aitormrtn/KEYHOME_PROYECT/README.md

# KEYHOME_PROYECT
Proyecto dedicado a la automatización de la reserva de viviendas de alquiler con caracter vacacional
