aitormrtn/KEYHOME_PROYECT/Memoria/tex/simbolos.tex

\chapter*{Lista de símbolos}\label{LDS}

\avisoLocalizacionArchivo

\begin{longtable}{lcp{.8\textwidth} }
\multicolumn{3}{l}{\textbf{Mayúsculas}}\\
\\
$V$ & --- & Voltaje (V).\\
\end{longtable}
