aitormrtn/KEYHOME_PROYECT/Memoria/README.md

# Plantilla para TFG en EII - UCLM

Este repositorio es una plantilla de trabajo fin de grado.

Los alumnos a los que dirijo el TFG tendrán que usarla a partir del curso 2018-2019.

## Usar la plantilla

1. Hazte una cuenta de GitHub y haz un fork de este repositorio.
1. Añade a mi usuario FranciscoMoya como uno de los colaboradores de tu nuevo repositorio.
1. Descarga como un zip el repositorio.
1. Hazte una cuenta en [Overleaf](https://v2.overleaf.com/).
1. Crea un nuevo proyecto a partir del ZIP descargado de GitHub.  Para ello pincha en *Nuevo proyecto* y selecciona *Subir proyecto*. 
1. Cada vez que tengas cambios significativos descarga los fuentes de Overleaf y súbelos a GitHub.  Para ello tendrás que aprender a usar un repositorio GitHub desde tu ordenador personal.
