aitormrtn/KEYHOME_PROYECT/Memoria/TFG.tex

\documentclass{sty/eiiatfg}

% Hay muchos paquetes para LaTeX que facilitan centenares de trabajos
% engorrosos. Busca en Internet si no sabes hacer algo con LaTeX. El
% repositorio oficial está en https://ctan.org/

% Algunos paquetes especialmente útiles ya están incluídos en el estilo
% del TFG (consulta sty/eiiatfg.cls para más detalles).

\input{datos-tfg.tex}
\input{acronimos.tex}

% La bibliografía la puedes descomponer en varios archivos .bib
% Los archivos .bib se pueden escribir a mano con ayuda de un editor online
% (e.g. http://truben.no/latex/bibtex) o generar con Mendeley u otro
% gestor de bibliografía. Solo se incluyen las referencias que son citadas
% en el texto.
\addbibresource{bib/main.bib}
%\addbibresource{bib/how.bib}
%\addbibresource{bib/ejemplos.bib}

\fxsetup{draft,lang=spanish,theme=color,inlineface=\bfseries,marginface=\bfseries,layout={marginclue,inline,index}}

\begin{document}

% Puedes cambiar la licencia de este documento con la orden license.  Por defecto se asume Creative Commons Attribution 4.0 (ver https://creativecommons.org/licenses/by/4.0/).  
% Por ejemplo, para restringir su uso, copia y distribución:
%\license{Todos los derechos reservados.}

% Si usas muchos símbolos conviene que describas lo que significan en un archivo
% aparte (en este caso simbolos.tex).  Si no es el caso puedes comentar esta línea
\listofsymbols{simbolos.tex}

\portada
\input{agradecimientos.tex}	   
\input{dedicatoria.tex}
\input{resumen.tex}

\indices
%Poniendo \if0 hacemos que los puntos que haya debajo no se compilen
%\fi %% fin de \if0 A partir de aquí el \if0 ya no tendría efecto
% Para incluir un fragmento basta sustituir el \if0 por \if00 (un cero más).

% El cuerpo del documento está en la carpeta tex
% Aquí simplemente se incluyen los archivos correspondientes a cada capítulo.

% No los llames capitulo1, capitulo2, etc. Los números los pondrá LaTeX según
% el orden en que los pongas.  Eso facilitará después su posible reordenación
% o división.

% Esta estructura corresponde a un documento científico-técnico.
% Si ves que tu proyecto concuerda con un trabajo profesional organiza el 
% documento según UNE 157001

\if00
\input{introduccion.tex}
\fi

\if00
\input{objetivos.tex}
\fi

\if00
\input{antecedentes.tex}
\fi

\if00
\input{procedimiento.tex}
\fi

\if00
\input{desarrollo.tex}
\fi

\if00
\input{resultados.tex}
\fi

\if00
\input{tex/discusion-resultados}
\fi

\if00
\input{conclusiones.tex}
\fi

% Los anexos pueden ir en la misma carpeta que el cuerpo del documento 
% porque eso facilita la migración de partes de un capítulo a un anexo.
\appendix\cleardoublepage
\if0
\hypertarget{ch:anexos}{%
    \input{latex.tex}}
\fi
% La bibliografía no suele ir numerada porque se pone después de los anexos.
% No se debe poner antes de los anexos porque si se cita una referencia en
% un anexo sería una backward reference, que deben evitarse a toda costa
\cleardoublepage
\hypertarget{ch:bibliografia}{%
    \printbibliography[heading=bibintoc,title={Bibliografía}]}
\cleardoublepage

\end{document}
