aitormrtn/KEYHOME_PROYECT/Memoria/tex/agradecimientos.tex

\begin{agradecimientos}
\noindent Quiero agradecerle a mi familia, especialmente a mis padres y a mi tío Javier, por haberme brindado la oportunidad de obtener una formación de calidad, ayudándome en todo momento de forma incondicional.

También quiero darle las gracias al tutor de este trabajo, Francisco Moya, por acercar el mundo de la programación a mi vida, y en general, a todos los docentes que me han acompañado en el camino, con especial atención por aquellos que sienten pasión por su trabajo y se la transmiten a sus alumnos.
\end{agradecimientos}
