aitormrtn/KEYHOME_PROYECT/Memoria/tex/dedicatoria.tex

\begin{dedicatoria}
Esta obra está dedicada a la memoria de Alan Turing, cuya contribución tecnológica hace posible, entre otras muchas cosas, este trabajo de fin de grado.
\end{dedicatoria}
