aitormrtn/KEYHOME_PROYECT/Memoria/fig/Conexion-Portero-Cerradura.PNG

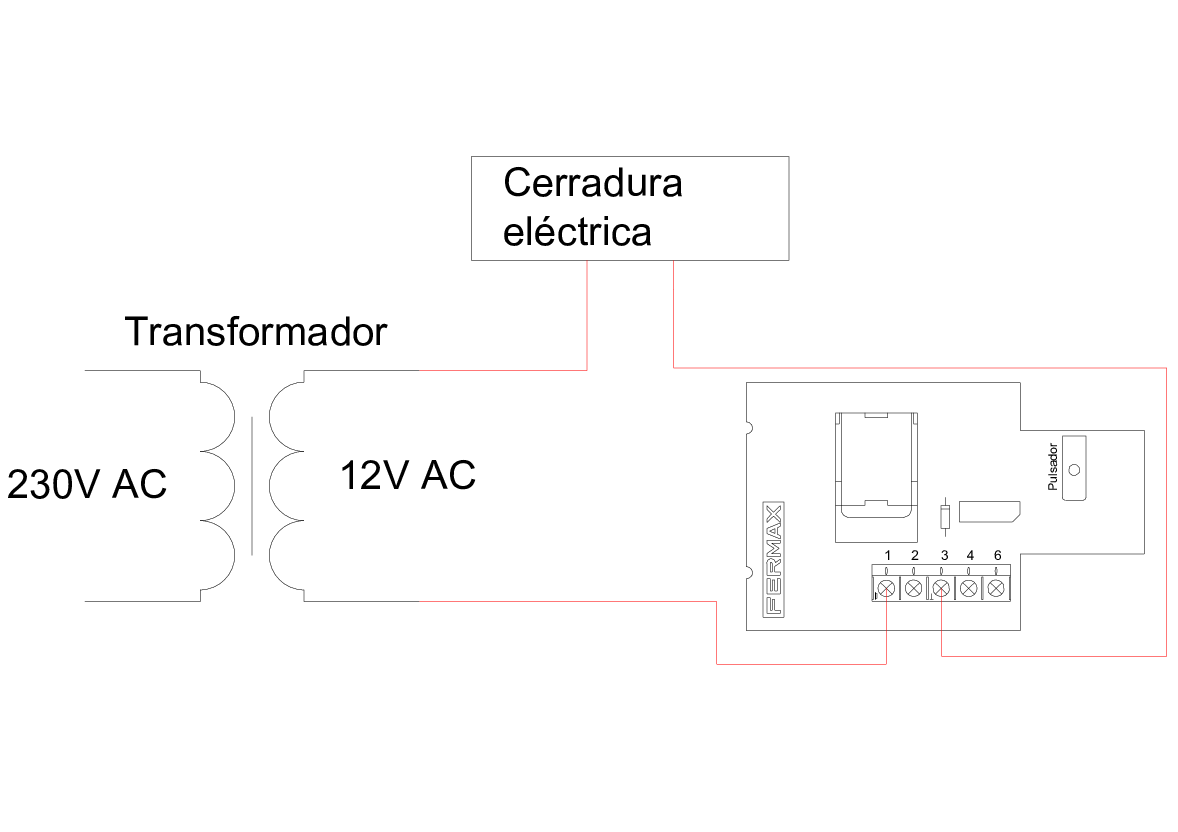
Memoria/fig/Conexion-Portero-Cerradura.PNG
