aitormrtn/KEYHOME_PROYECT/Memoria/fig/Proceso_Nueva_Reserva.png

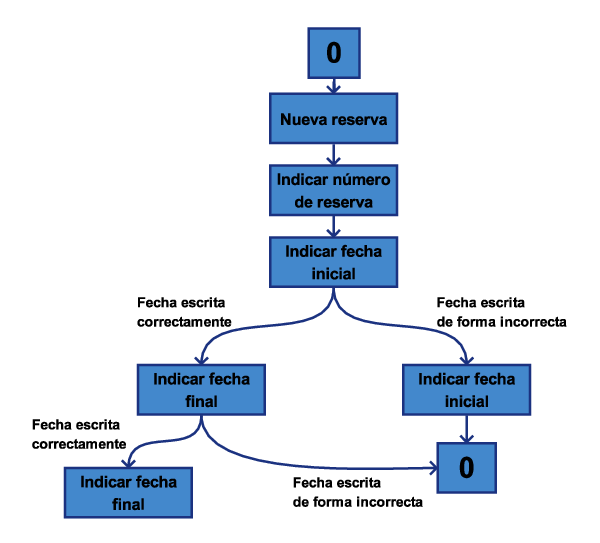
Memoria/fig/Proceso_Nueva_Reserva.png
