aitormrtn/KEYHOME_PROYECT/3D/Keyhome v5.step

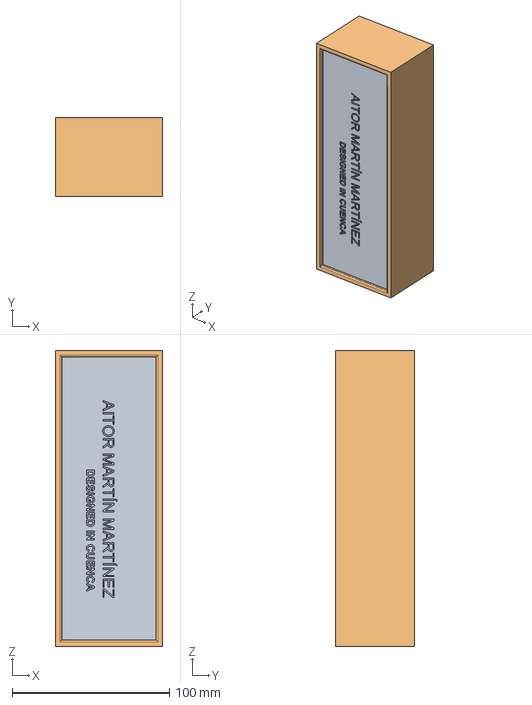
[picture p23: CAD file, 2020-03-31]
3D/Keyhome v5.step
68.0 x 50.0 x 188.0 mm
BASE V1
TAPA V1
