aitormrtn/KEYHOME_PROYECT/(list of files, cad)

Other CAD files:
3D/Keyhome v5.dwg
3D/Keyhome v5.f3d
3D/Keyhome v5.obj
3D/Keyhome v5.skp
3D/Keyhome v5.stl
