aitormrtn/KEYHOME_PROYECT/Memoria/fig/conexion-keyhome-completa.pdf

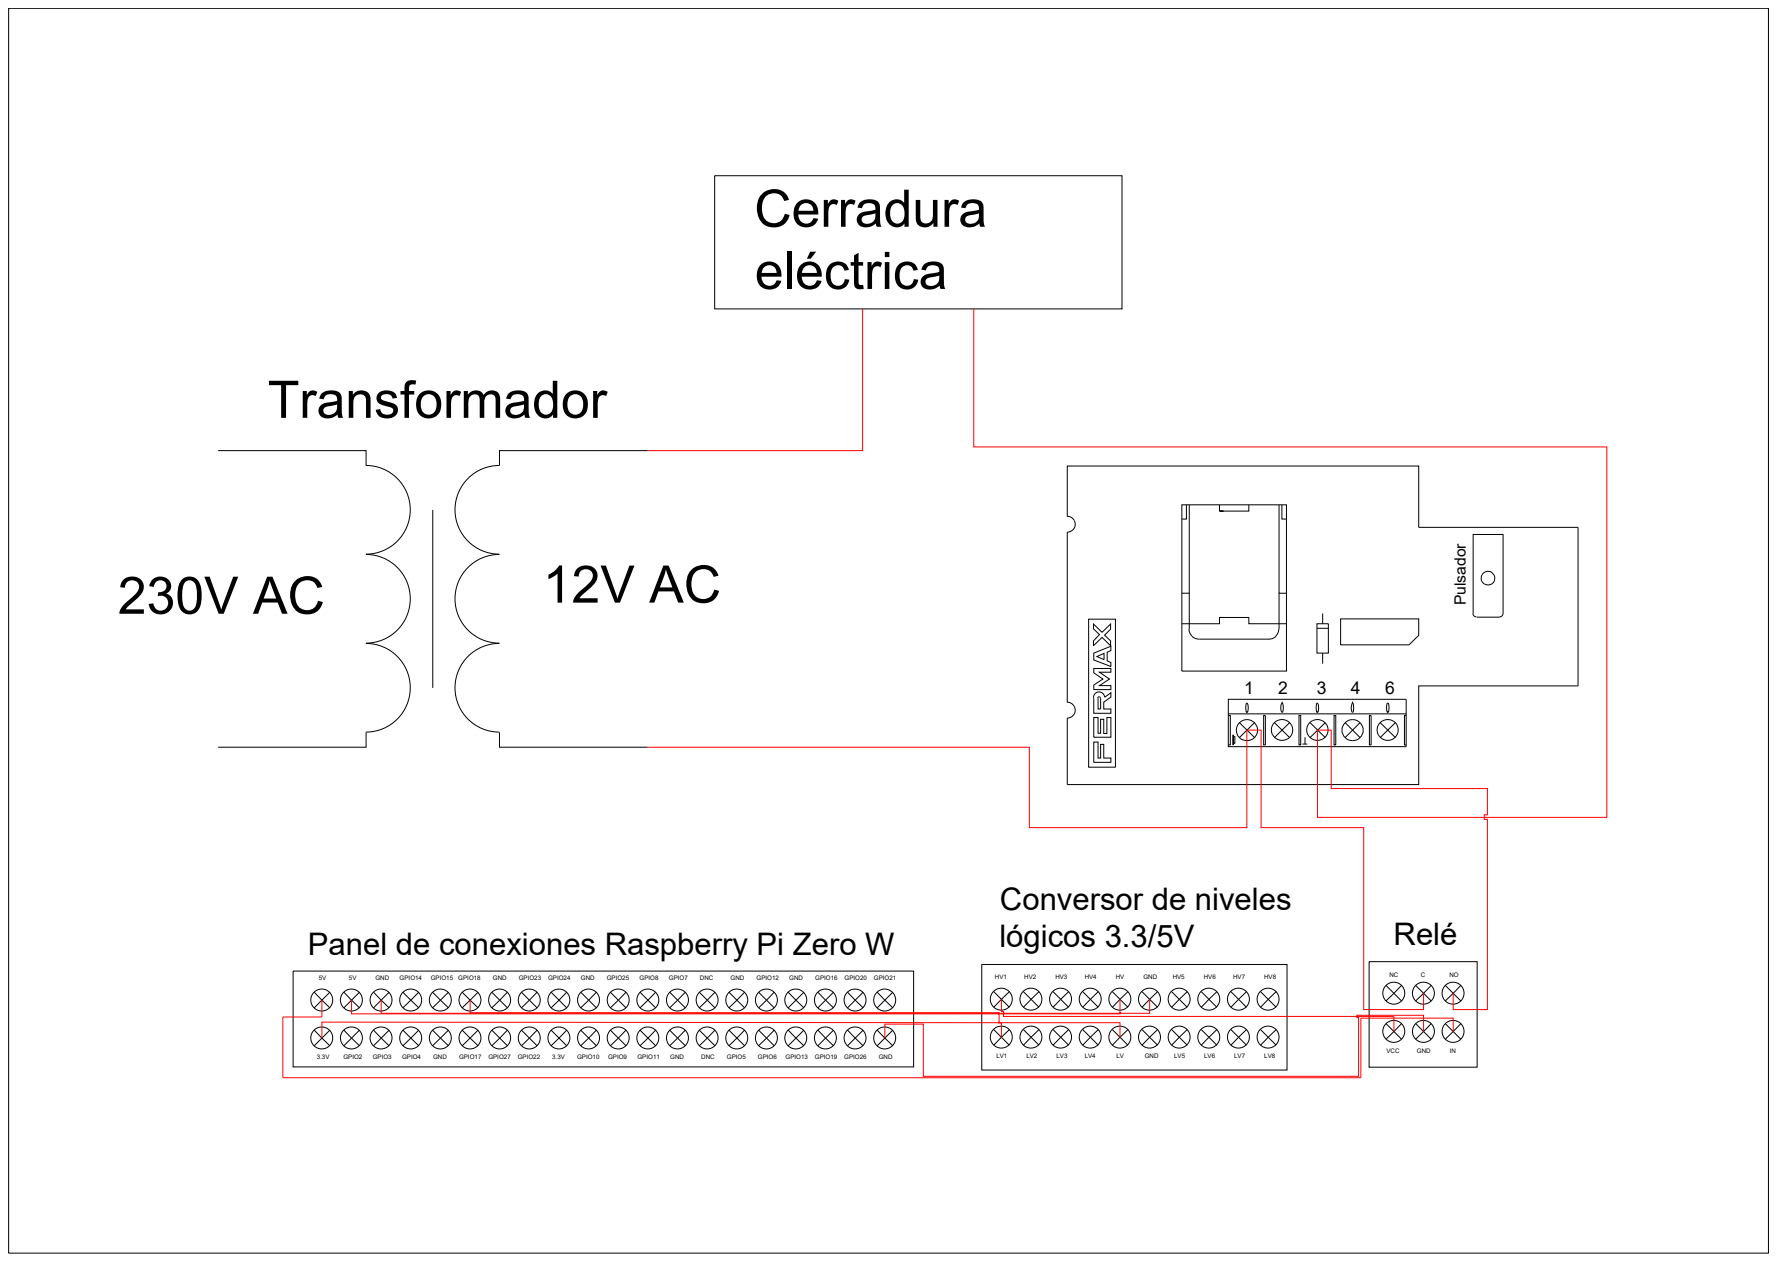
[picture p36: page 1]
Transformador 230V AC; 12V AC Cerradura eléctrica

Pulsador HV1 HV2 HV3 HV4 HV GND HV5 HV6 HV7 HV8 LV1 LV2 LV3 LV4 LV GND LV5 LV6 LV7 LV8 Conversor de niveles lógicos 3.3/5V 5V 5V GND GPIO14 GPIO15 GPIO18 GND GPIO23 GPIO24 GND GPIO25 GPIO8 GPIO7 DNC GND GPIO12 GND GPIO16 GPIO20 GPIO21 3.3V GPIO2 GPIO3 GPIO4 GND GPIO17 GPIO27 GPIO22 3.3V GPIO10 GPIO9 GPIO11 GND DNC GPIO5 GPIO6 GPIO13 GPIO19 GPIO26 GND Panel de conexiones Raspberry Pi Zero W VCC GND IN NC C NO Relé
