aitormrtn/KEYHOME_PROYECT/Memoria/fig/Conexion-Portero-Cerradura.pdf

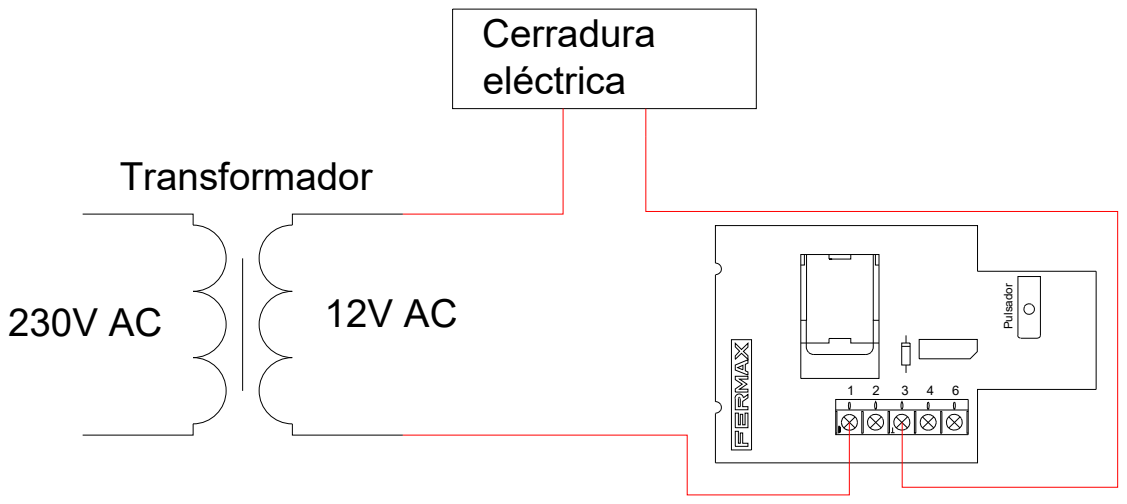
[picture p37: page 1]
Transformador 230V AC; 12V AC Cerradura eléctrica
