aitormrtn/KEYHOME_PROYECT/Memoria/fig/Grafcet_creacion_nueva_reserva.pdf

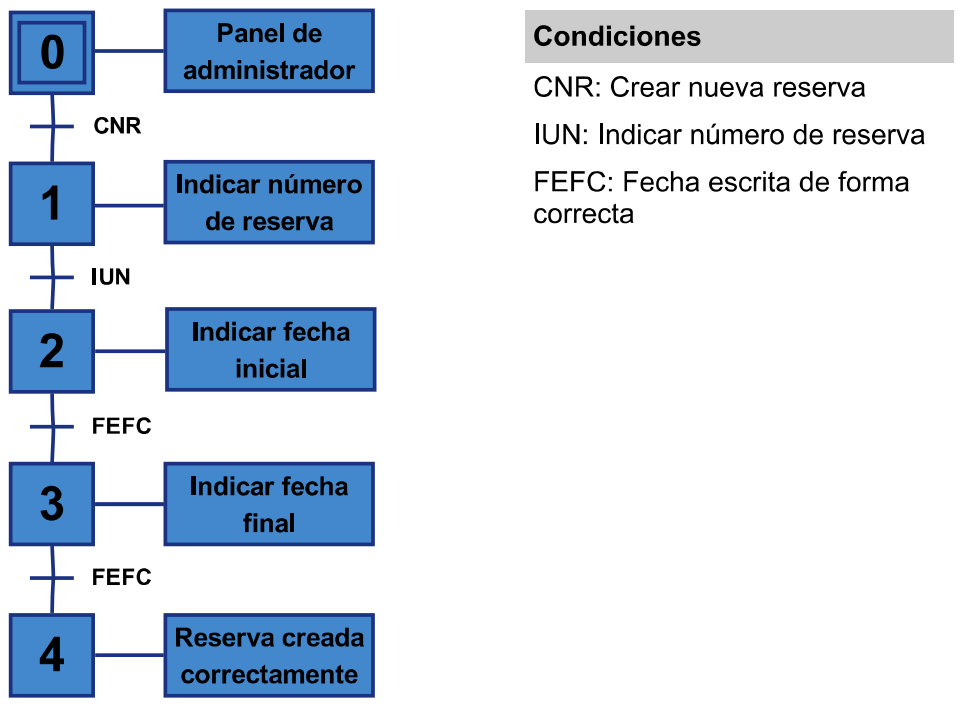
[picture p38: page 1]
