aitormrtn/KEYHOME_PROYECT/Memoria/fig/Grafcet_reserva_apertura_y_dejar_administracion.pdf

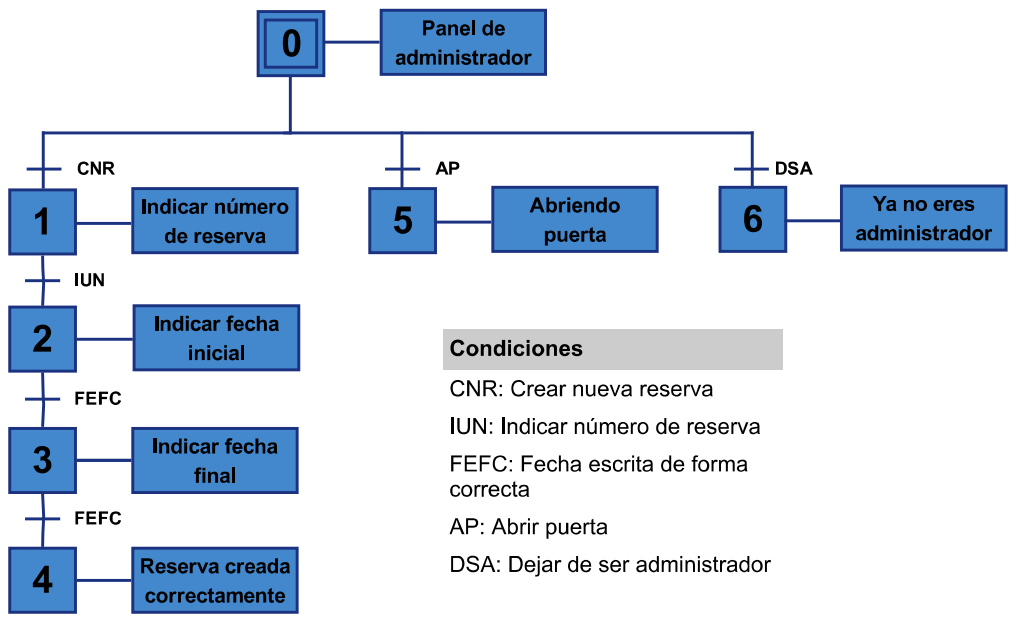
[picture p39: page 1]
