aitormrtn/KEYHOME_PROYECT/Memoria/fig/Grafcet_reserva_y_apertura.pdf

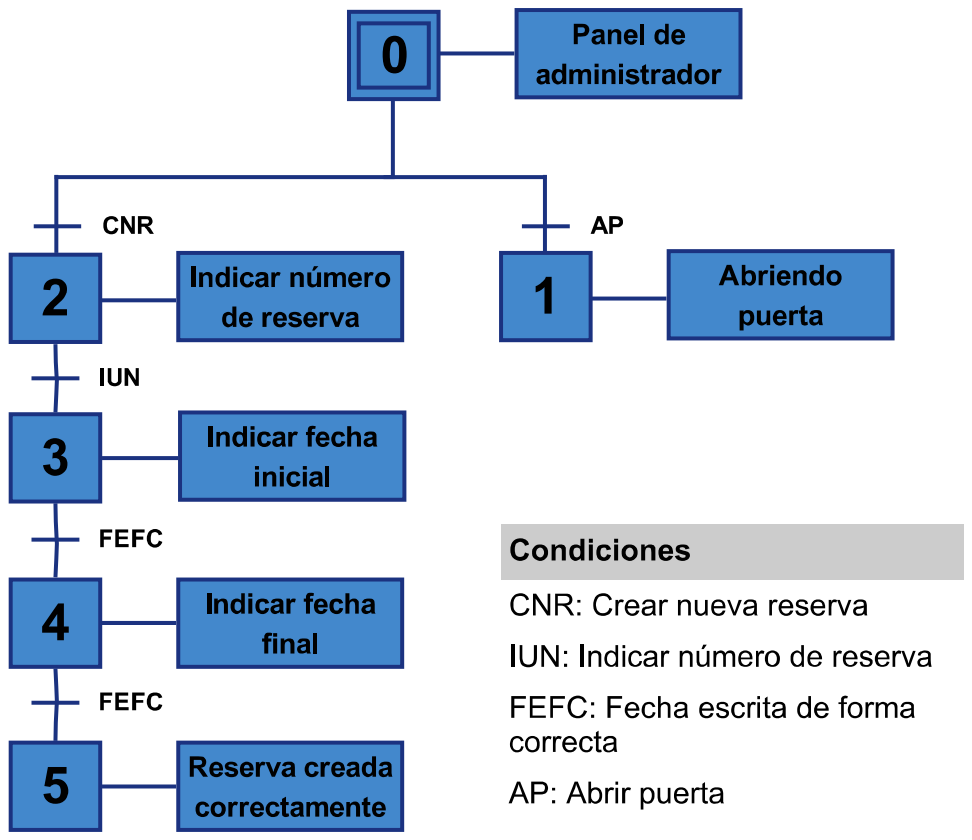
[picture p40: page 1]
