aitormrtn/KEYHOME_PROYECT/Memoria/fig/Panel_administrador_completo.pdf

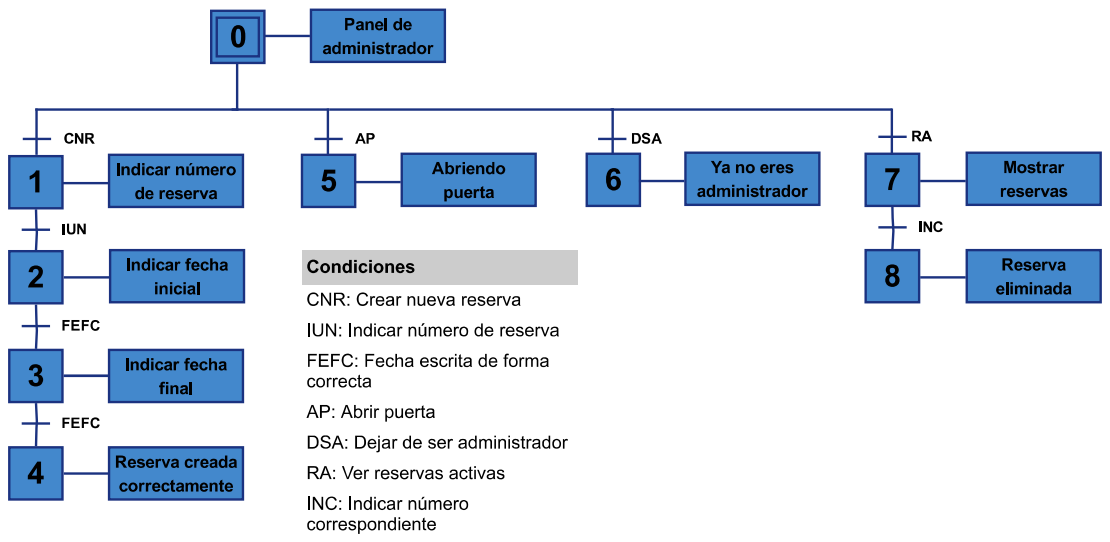
[picture p41: page 1]
