aitormrtn/KEYHOME_PROYECT/Apertura de puertas/Sin título0.py

# -*- coding: utf-8 -*-
"""
Created on Wed Jan 22 09:20:12 2020

@author: Usuario
"""

import commands

result=commands.getoutput("/Users\Usuario\Google Drive\TFG\GIT\KEYHOME_PROYECT\Apertura de puertas\python keyhome.py")
