aitormrtn/KEYHOME_PROYECT/(commit log)

2019-10-22 Ordenación de documentos
    En esta actualización se ha procedido a ordenar de forma correcta los documentos apertura-puertas.py y quickstart.py por carpetas, con el fin de seguir un orden correcto en el desarrollo del proyecto
2020-01-23 Actualización 23/01/2020
    Introducción del programa que avisa cuando se manipula la caja
2020-03-15 Importada la memoria de Overleaf
2020-03-15 Some minor spelling changes
    Dwelling is not the term you would use to refer to temporal housing. Saxon's genitive should not be used with inanimated beings. TFG may be translated into diploma thesis (e.g. Italy), final year project (e.g. UK), degree project. I used the UK term, feel free to change it.
2020-03-31 Diseño en 3D
    Diseño en 3D con el fin de aumentar la estética y la seguridad del prototipo
    [Keyhome v5.dwg, Keyhome v5.f3d, Keyhome v5.obj, Keyhome v5.skp, Keyhome v5.step, Keyhome v5.stl]
