aitormrtn/KEYHOME_PROYECT/Memoria/fig/Prototipo_Completo.jpg

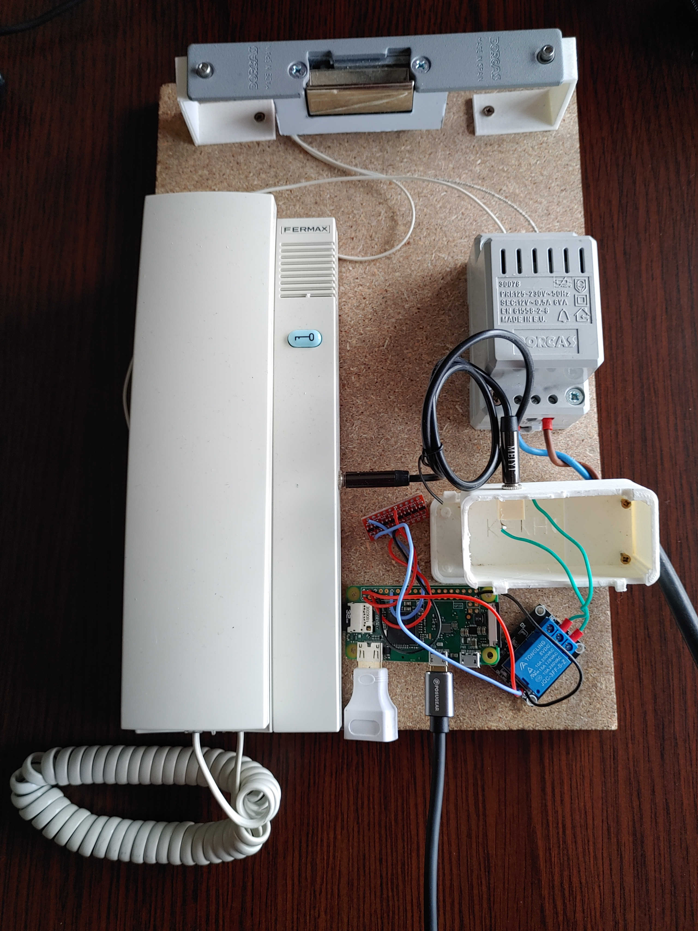
[picture p24: Memoria/fig/Prototipo_Completo.jpg]
Memoria/fig/Prototipo_Completo.jpg
